TetherIA/aero-hand-open/hardware/CAD/mount_adapters/G1_Open_Unitree_Converter.stp

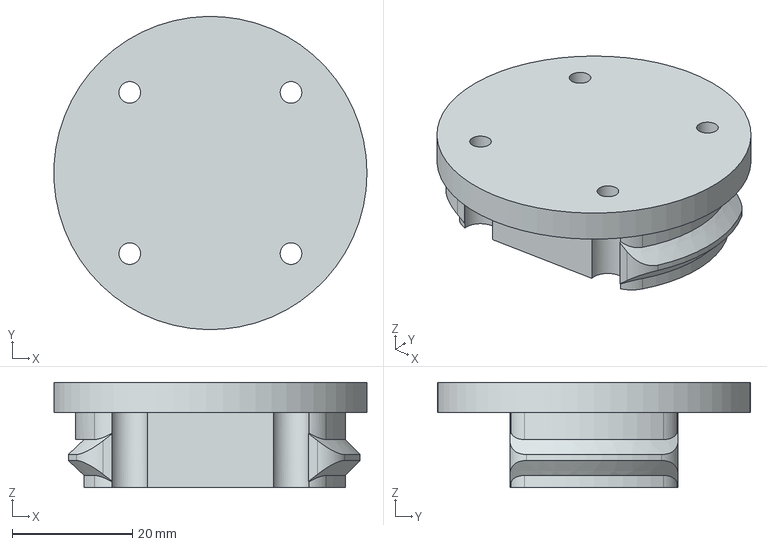
[picture p1: CAD file, 2026-03-13]
hardware/CAD/mount_adapters/G1_Open_Unitree_Converter.stp
52.2 x 52.2 x 17.5 mm
