TetherIA/aero-hand-open/(commit log)

2026-02-25 git subrepo pull --branch=public_release ros2
    subrepo:
    subdir: "ros2"
    merged: "2c1bfab"
    upstream:
    origin: "https://github.com/TetherIA/aero-open-ros2.git"
    branch: "public_release"
    commit: "2c1bfab"
    git-subrepo:
    version: "0.4.9"
    origin: "https://github.com/ingydotnet/git-subrepo.git"
    commit: "8bbc88c"
    [aero_hand_open_left.urdf]
2026-03-13 add G1_Open_Unitree_Converter for unitree g1 add G1_Open_Unitree_Converter for unitree g1
    [G1_Open_Unitree_Converter.stp]
2026-09-05 Add arXiv paper link and citation to README
    The work is now published as arXiv:2608.28578 ("Aero Hand Open: A
    Simulation-Ready Tendon-Driven Hand for Dexterous Manipulation
    Learning"). Adds an arXiv badge, a Paper quick-link, and a Citation
    section with the BibTeX entry.
2026-09-05 Add arXiv paper link and citation to project page
    Adds a "Paper (arXiv)" button to the hero link row, updates the BibTeX
    block to the published citation (arXiv:2608.28578), and fills in the
    Google Scholar citation_* meta tags and JSON-LD identifier for the paper.
